ppak10/Inova/BOM/AllOtherConstructionPartsMK1_05062024.xlsx

Part Name | Part Description | Where To Buy | Notes
Balls for wobbler balancer, d. 6.35mm | Balls for wobbler balancer, d. 6.35mm | https://s.click.aliexpress.com/e/_DCx0Q8L
Gas Dumper for TopFrame, 230mm, 120N | Gas dumper for the horizontaly placed doors. | your local shop
Gas Dumper Holder | Gas dumper holder. | your local shop
Neodyme magnet 10x5mm | Magnets for wobler ballancer. | https://s.click.aliexpress.com/e/_DDN6NvZ
Spring for anti wobbler | Spring: 0,5x7x15 | https://s.click.aliexpress.com/e/_DCy5gN9
Spring for belt tensioner | Spring for belt tensioner | https://s.click.aliexpress.com/e/_DCy5gN9
Steel Hinges, 50x50mm | Hinges for the printer opening. | https://s.click.aliexpress.com/e/_DlhNYs3
L-Profile RockWool Holder | Aluminum insulation holder above the recoater, 20x40x2mm | to be manufactured | see 3D model
L-Profile Z-axes Reinforcement | Aluminum reinforcement of Z1 and Z2 axes, 30x30x4mm | to be manufactured | see 3D model
SteelMagPlate | Stell plate for the electro magnet closing. | to be manufactured | see 3D model
