ppak10/Inova/BOM/CH-PRPWSET-_-Bed-Sealing-MK1_BOM.xlsx

Part | Quantity | Notes
Bed Sealing - CornerSpringWasher | 8 | aluminum, see 3D model
Bed Sealing - Felt Sealing for Powder Bed | 2 | Nomex Felt or Ceramic Paper, see 3D model
Bed Sealing - Felt Sealing for Print Bed | 2 | Nomex Felt or Ceramic Paper, see 3D model
Bed Sealing - SideSpringWasherLong | 2 | aluminum, see 3D model
Bed Sealing - SideSpringWasherShort | 6 | aluminum, see 3D model
Bed Sealing - TopPlateSpacerLong | 2 | aluminum, see 3D model
Bed Sealing - TopPlateSpacerShort | 6 | aluminum, see 3D model
