ppak10/Inova/BOM/CH-PRPWSET-_-Chambers-for-Inova-MK1_BOM.xlsx

Part | Quantity | Notes
Chambers - BottomMovingPlate | 2 | 8mm aluminum, see 3D model
Chambers - ChamberCornerR16 | 8 | 3mm aluminum, see 3D model
Chambers - ChamberSideLong | 2 | 3mm aluminum, see 3D model
Chambers - ChamberSideShort | 6 | 3mm aluminum, see 3D model
Chambers - HeatingBlock | 8 | alu profile 1530, see 3D model
Chambers - ChamberSideConnector | 16 | 3mm aluminum, see 3D model
Chambers - PowderBedBottom | 1 | 3mm aluminum, see 3D model
Chambers - PowderBedTop | 1 | 3mm aluminum, see 3D model
Chambers - PrintBedBottom | 1 | 3mm aluminum, see 3D model
Chambers - PrintBedTop | 1 | 3mm aluminum, see 3D model
