ppak10/Inova/BOM/Fasteners_Joints_BottomFrame_MK1_05062024.xlsx

Type | Size | Length (mm) | Pcs | Joint
Socket Cap Screw | M5 | 25 | 4 | Profiles 2020 BCF/BCB + Profiles 2020 BCLR
Socket Flat Screw | M5 | 8 | 1 | Profile 20: BCC + TopChamberCover
Socket Button Screw | M5 | 10 | 5 | FrontCover + Frame
Socket Button Screw | M5 | 10 | 5 | BackCover + Frame
Socket Button Screw | M5 | 10 | 6 | RightCover + Frame
Socket Flat Screw | M5 | 12 | 2 | RightCover + Profile2020 holding Chambers
Socket Flat Screw | M5 | 12 | 2 | RightCover + Profile2020 holding LinearRails
Socket Button Screw | M5 | 10 | 6 | LeftCover + Frame
Socket Flat Screw | M5 | 12 | 2 | LeftCover + Profile2020 holding Chambers
Socket Flat Screw | M5 | 12 | 2 | LeftCover + Profile2020 holding LinearRails
Socket Flat Screw | M5 | 10 | 10 | TopFrameCover_HPL + Frame
Socket Flat Screw | M4 | 8 | 16 | TopFrameCover_HPL + TopFrameCover_ALU
Socket Flat Screw | M5 | 10 | 8 | Hinges + Frame
Socket Flat Screw | M4 | 10 | 2 | BeltTensioner_FixedReaction + RightCover
Socket Cap Screw | M4 | 16 | 2 | BeltTensioner_FixedReaction + RecoaterServiceWindowCover
Socket Cap Screw | M4 | 8 | 4 | RecoaterServiceWindowCover + BackCover
Socket Cap Screw | M4 | 8 | 1 | RecoaterServiceWindowCover+BeltTensioner_FixedReactionBrace
Socket Cap Screw | M4 | 8 | 4 | RecoaterNema17_Holder + BackCover
Socket Button Screw | M5 | 10 | 16 | insideCoverConnector + Frame
Socket Cap Screw | M4 | 8 | 8 | insideCoverConnector + InsideCovers
Socket Flat Screw | M4 | 6 | 6 | RockwoolHolders + InsideCovers
Socket Button Screw | M5 | 8 | 2 | InsideLeftWollHolder + Frame
Socket Flat Screw | M5 | 14 | 10 | TopChamberCovers + PowderMantinels + Frame
Socket Flat Screw | M5 | 12 | 3 | TopChamberCovers + Frame
Socket Cap Screw | M4 | 8 | 16 | SideCompactConnector + Left&RightCover
Socket Cap Screw | M4 | 8 | 8 | SideCompactConnector + Front&BackInsideCover
Socket Flat Screw | M4 | 10 | 6 | OverPowderBin_PrinterRails + BottomChamberCover
Socket Button Screw | M5 | 12 | 3 | OverPowderLinePlateBack + Frame
Socket Cap Screw | M4 | 18 | 8 | OverPowderLinePlateBack + OverPowderLinePlateFront
Socket Flat Screw | M4 | 10 | 2 | OverLinePlateHolder + BottomChamberCoverRight
Socket Button Screw | M4 | 10 | 4 | OverLinePlateHolder + InsideFront&BackHoldersBottom
Socket Flat Screw | M4 | 10 | 40 | OverPowderBin M4 set
Socket Flat Screw | M3 | 12 | 6 | OverPowderBin M3 set
Cylindrical Knurled Head | M5 | 10 | 1 | OverPowderBin Lock (DIN 464)
Socket Button Screw | M5 | 10 | 24 | "BottomChamberCovers" + Frame
Socket Button Screw | M4 | 8 | 30 | "CleaningCovers"+"BottomChamberCovers"
Socket Button Screw | M4 | 8 | 20 | "SSR Box": Sides + Mounts
Socket Button Screw | M5 | 16 | 4 | "SSRBoxMounts" + Frame
Socket Cap Screw | M4 | 8 | 4 | CableClipSmall + "SSRBox"
Socket Cap Screw | M4 | 8 | 4 | CableClipBig + "SSRBox"
Socket Button Screw | M5 | 8 | 4 | GasDumpers + Frame
Socket Button Screw | M5 | 10 | 8 | Z-axisReinforcements + Frame
Socket Button Screw | M5 | 8 | 28 | "Frame Blind Joint Screws"
Socket Cap Screw | M5 | 20 | 12 | "Frame Holding Z1/Z2 steppers and LinearRails"
Socket Cap Screw | M5 | 25 | 4 | "Frame Joint Holding Chambers - Bottom"
Squared Nut, Low Profile | M5 | 2.7 | 111 | "Anything" + Frame
