ppak10/Inova/BOM/Fasteners_Joints_LayerProcessor_MK1_05062024.xlsx

Type | Size | Length (mm) | Pcs | Joint
Socket Cap Screw | M3 | 18 | 1 | LeadPulley + LeadPulleyHolder (Axle)
Flat Washer | M3 | 0.5 | 2 | LeadPulley + LeadPulleyHolder (Axle)
Self Locking Nut | M3 | --- | 1 | LeadPulley + LeadPulleyHolder (Axle)
Socket Cap Screw | M5 | 30 | 2 | BeltTensionerSet: "FixedReaction Spring Guide"
Socket Cap Screw | M4 | 25 | 2 | BladeHolders + Blade
Socket Cap Screw | M3 | 10 | 8 | BladeHolders + LinearRailTrolley
Socket Cap Screw | M3 | 8 | 16 | LinearRails + Profile 2020
Profile 2020 Spring Nut | M3 | --- | 16 | LinearRails + Profile 2020
Socket Button Screw | M4 | 14 | 1 | BladeHolder + BeltLock
