ppak10/Inova/BOM/Fasteners_Joints_PowderChamber_MK1_05062024.xlsx

Type | Size | Length (mm) | Pcs | Joint
Socket Cap Screw | M3 | 8 | 8 | BedSealingSet + PrintBedBottom
Socket Flat Screw | M4 | 16 | 8 | PowderBedTop + PowderBedBottom
Socket Button Screw | M5 | 18 | 2 | PowderBedBottom + RingSpacer + MovingProfiles
Spring washer | M5 | 1.6 | 2
Socket Cap Screw | M5 | 25 | 2 | BottomMovingPlate + RingSpacer + MovingProfiles
Socket Cap Screw | M4 | 10 | 4 | RingSpacer + NutAretation
Socket Cap Screw | M4 | 12 | 3 | LeadNut + BalancerPlateBottom
Socket Cap Screw | M4 | 35 | 3 | LeadNut+BalancerPlateBottom + BottomPlate + BalancerPlateTop
M4 Nut | M4 | 3.2 | 3 | BalancerPlateBottom Aretation
Socket Cap Screw | M4 | 14 | 2 | NutHolder + BalancerPlateBottom
Socket Cap Screw | M4 | 14 | 6 | BottomMovingPlate + BottomPlateHolders
Socket Cap Screw | M3 | 12 | 8 | BottomPlateHolders + LinearRailTrolleys
Socket Button Screw | M4 | 6 | 8 | ChamberSideConnectors + ChamberSides (not frame)
Socket Cap Screw | M4 | 6 | 32 | ChamberSideConnectors + ChamberSides (not frame)
Socket Cap Screw | M4 | 5 | 24 | HeatingBlocks + ChaberSides
Socket Cap Screw | M3 | 8 | 8 | LinearRails + Profile 2020
Profile 2020 Spring Nut | M3 | --- | 8 | LinearRails + Profile 2020
Distance Washer | M5 | 0.1 | 10 | LinearRails + Profile 2020
Distance Washer | M5 | 0.2 | 10 | LinearRails + Profile 2020
Washer | 8,4x20x1,5 | 1.5 | 1 | Z-axis End-Stop
Socket Button Screw | M4 | 10 | 4 | "Chambers with Frame_Top_Xaxis"
Socket Cap Screw | M4 | 22 | 2 | "Chambers with Frame_Top_Yaxis"
Socket Cap Screw | M4 | 22 | 2 | "Chambers with Frame_Bottom"
