ppak10/Inova/BOM/Fasteners_Joints_TopFrame_MK1_05062024.xlsx

Type | Size | Length (mm) | Pcs | Joint
Socket Flat Screw | M5 | 10 | 10 | TopTopCover + Frame
Socket Button Screw | M5 | 10 | 6 | RightCover + Frame
Socket Button Screw | M5 | 10 | 6 | LeftCover + Frame
Socket Button Screw | M5 | 10 | 7 | FrontCover + Frame
Socket Button Screw | M5 | 10 | 8 | BackCover + Frame
Socket Flat Screw | M5 | 10 | 10 | TopBottomCover_HPL + Frame
Socket Button Screw | M5 | 12 | 3 | RightInsideCover + Frame
Socket Button Screw | M5 | 12 | 3 | LeftInsideCover + Frame
Socket Button Screw | M5 | 12 | 3 | FrontInsideCover + Frame
Socket Button Screw | M5 | 12 | 3 | BackInsideCover + Frame
Socket Flat Screw | M4 | 8 | 16 | TopBottomCover_HPL + TopBottomCover_ALU
Socket Button Screw | M5 | 12 | 8 | TopCenterCover + Frame
Socket Flat Screw | M5 | 12 | 4 | Left&RightCovers + InsideProfiles (holding electronics)
Socket Flat Screw | M5 | 10 | 8 | ElectronicPlate + InsideProfiles (holding electronics)
Socket Cap Screw | M4 | 8 | 8 | WindowsHolder + TopCenterCover
Socket Flat Screw | M5 | 10 | 8 | Hinges + Frame
Socket Button Screw | M5 | 8 | 4 | GasDumpers + Frame
Socket Cap Screw | M4 | 8 | 12 | Halogen Heaters: HalogenHeaterHolder + TopBottomCover_Alu
Socket Cap Screw | M4 | 6 | 32 | Halogen Heaters: HalogenHeaterHolder + Shields
Socket Cap Screw | M4 | 10 | 8 | Halogen Heaters: HalogenTubes position set screws
Socket Button Screw | M5 | 10 | 4 | "Frame Blind Joint Screws: Inside Frame"
Squared Nut, Low Profile | M5 | 2.7 | 79 | "Anything" + Frame
