ppak10/Inova/BOM/Fasteners_MK1_05062024.xlsx

Part | Quantity | Where to buy | Notes
Cylindrical Knurled Head M5x10 | 1 | your local shop
Distance Washer M5x0,1 | 20 | your local shop
Distance Washer M5x0,2 | 20 | your local shop
Nut M4x3,2 | 6 | your local shop
Square Low Profile Nut M5x2,7 | 200 | your local shop
Profile 2020 Spring Nut M3 | 32 | your local shop
PTFE Washer 4x10x1 | 50 + some spare | https://www.aliexpress.com/store/3209034 | Ask for custom dimensions
PTFE Washer 5x10x1 | 16 + some spare | https://www.aliexpress.com/store/3209034 | Ask for custom dimensions
PTFE Washer 5x18x3 | 77 + some spare | https://www.aliexpress.com/store/3209034 | Ask for custom dimensions
Self Locking Nut | 1 | your local shop
Socket Button Screw M3x16 | 4 | your local shop
Socket Button Screw M3x6 | 10 | your local shop
Socket Button Screw M4x10 | 12 | your local shop
Socket Button Screw M4x14 | 4 | your local shop
Socket Button Screw M4x18 | 2 | your local shop
Socket Button Screw M4x6 | 16 | your local shop
Socket Button Screw M4x8 | 50 | your local shop
Socket Button Screw M5x10 | 125 | your local shop
Socket Button Screw M5x12 | 25 | your local shop
Socket Button Screw M5x16 | 4 | your local shop
Socket Button Screw M5x18 | 4 | your local shop
Socket Button Screw M5x8 | 38 | your local shop
Socket Cap Screw M2x4 | 4 | your local shop
Socket Cap Screw M3x10 | 21 | your local shop
Socket Cap Screw M3x12 | 16 | your local shop
Socket Cap Screw M3x18 | 5 | your local shop
Socket Cap Screw M3x25 | 4 | your local shop
Socket Cap Screw M3x8 | 79 | your local shop
Socket Cap Screw M4x10 | 16 | your local shop
Socket Cap Screw M4x12 | 9 | your local shop
Socket Cap Screw M4x14 | 16 | your local shop
Socket Cap Screw M4x16 | 2 | your local shop
Socket Cap Screw M4x18 | 11 | your local shop
Socket Cap Screw M4x22 | 8 | your local shop
Socket Cap Screw M4x25 | 2 | your local shop
Socket Cap Screw M4x35 | 6 | your local shop
Socket Cap Screw M4x5 | 48 | your local shop
Socket Cap Screw M4x6 | 96 | your local shop
Socket Cap Screw M4x8 | 125 | your local shop
Socket Cap Screw M5x20 | 12 | your local shop
Socket Cap Screw M5x25 | 12 | your local shop
Socket Cap Screw M5x30 | 2 | your local shop
Socket Flat Screw M3x12 | 6 | your local shop
Socket Flat Screw M3x8 | 12 | your local shop
Socket Flat Screw M4x10 | 50 | your local shop
Socket Flat Screw M4x16 | 16 | your local shop
Socket Flat Screw M4x6 | 6 | your local shop
Socket Flat Screw M4x8 | 44 | your local shop
Socket Flat Screw M5x10 | 54 | your local shop
Socket Flat Screw M5x12 | 15 | your local shop
Socket Flat Screw M5x14 | 10 | your local shop
Socket Flat Screw M5x8 | 1 | your local shop
Spring washer M5x1,6 | 4 | your local shop
Washer 8,4x20x1,5 | 2 | your local shop
Washer M3x0,5 | 2 | your local shop
