ppak10/Inova/BOM/Heating_MK1_05062024.xlsx

Part | Description | Quantity | Where to buy | Notes
Ceramic Socket r7s | Ceramic socket r7s for halogen heaters. | 8 | https://s.click.aliexpress.com/e/_DCzVFIX | Type: any, you need just a ceramic part
Halogen Heater 185mm 110V or 230V | Halogen Tube 200W, 185mm, R7s socket, half-shielded | 2 + 2 spare | https://s.click.aliexpress.com/e/_DDVj12b | Ask for customization
Halogen Heater 220mm 110V or 230V | Halogen Tube 200W, 220mm, R7s socket, half-shielded | 2 + 2 spare | https://s.click.aliexpress.com/e/_DDVj12b | Ask for customization
Heating Cartridges 110V or 230V | d6x140mm, M10 thread, 110/230V, 200W, 2m cable | 8 | https://s.click.aliexpress.com/e/_Dnl1lfz | Ask for customization - see 3D model
Heating Pad - Powder Bed 110V or 230V | 120x165mm Flexible Silicone Heating Bed 230V/110V, 200W | 1 | https://s.click.aliexpress.com/e/_DB4F0r1 | Ask for customization - see 3D model
Heating Pad - Print Bed 110V or 230V | 120x120mm Flexible Silicone Heating Bed 230V/110V, 200W | 1 | https://s.click.aliexpress.com/e/_DB4F0r1 | Ask for customization - see 3D model
Thermistor NTC3950 | Type NTC 3950 100k, M3 thread, 2m cable | 8 + 2 spare | https://s.click.aliexpress.com/e/_DkgYC1N | Ask for customization - 2m cable
