ppak10/Inova/BOM/HHEAD-ShieldSet-_-Halogen-Head_-Shield-Set_BOM.xlsx

Part | Quantity | Notes
Halogen Head: HeaterHolder1 | 2 | see 3D model
Halogen Head: HeaterHolder2 | 2 | see 3D model
Halogen Head: Shield185In | 2 | see 3D model
Halogen Head: Shield185Out | 2 | see 3D model
Halogen Head: Shield220In | 2 | see 3D model
Halogen Head: Shield220Out | 2 | see 3D model
