ppak10/Inova/BOM/LinearTechnics_MK1_05062024.xlsx

Part | Description | Quantity | Where to buy | Notes
Axial Bearings: 8x16x5 | Used in the Z1, Z2 NEMA17 holders. | 4 | https://s.click.aliexpress.com/e/_De1IwAr | Type: F8-16M 8 x 16 x 5mm
Ball Screw 1204 + Nut | Set for print & powder bed. | 2 | https://s.click.aliexpress.com/e/_DeIB02R | Ask for customization - see 3D model
GT2 Belt - Heat Resistant up to 135C | Used for recoater. Length: 1,25m | 1 | https://s.click.aliexpress.com/e/_DFZJ5G7 | Type:2M
GT2 Pulley - 20Z | Recoater stepper pulley - 20T. | 1 | https://s.click.aliexpress.com/e/_DDqpjtD | Type: Bore 3mm With Teeth
GT2 Tension Pulley 20T | Belt tensioning pulley - 20T. | 1 | https://s.click.aliexpress.com/e/_DDqpjtD | Type: Bore 3mm With Teeth
Hard Coupling 5/8 (For Stepper and Ball Screw) | Hard coupling for Z1 and Z1 steppers. Size: 20/25, 5/8mm | 2 | https://s.click.aliexpress.com/e/_DlnVikr | Type: 5x8
Lock Collar T8 | Stop for the Z1 and Z2 home positions. | 2 | https://vi.aliexpress.com/item/1005005321139532.html
MGN12H Linear rail & trolley set: 300mm | Used for print bed & powder bed Z-moves. | 4 | https://s.click.aliexpress.com/e/_Dnc20mn | Type: 300mm, MGN12H
MGN12H Linear rail & trolley set: 550mm | Used for the recoater moves. | 2 | https://s.click.aliexpress.com/e/_Dnc20mn | Type: 550mm, MGM12H
