ppak10/Inova/BOM/Electronics_MK1_05062024.xlsx

Part | Description | Quantity | Where to buy | Notes
10 pin Ribbon Cable, 60cm | BTT Board - GATE1 connestion. EXT connectors. | 2 | https://s.click.aliexpress.com/e/_DBJhg1t
40 pin Cable, 30cm | Raspberry Pi 5 - GATE1 connection. 40-pin header. | 1 | https://s.click.aliexpress.com/e/_DFkQEoB
Arduino Nano v3 | Arduino Nano v3 with pin header. | 1 | https://vi.aliexpress.com/item/1005001447227362.html
BTT SKR V1.4 Turbo 32-Bit + 3xTMC2209 | Big Tree Tech control board: SKR 1.4 Turbo + 3xTMC2209 | 1 | https://s.click.aliexpress.com/e/_DCPX7z5
Buck Convertor DC12V -> DC5V | PSU for Raspberry Pi. | 1 | https://s.click.aliexpress.com/e/_DdI4QqR
Cable Set for MK1 | Complete cabling for Inova MK1. | 1 | your local shop | To be manufactured by you.
Cable Splitter, 5pin | Cable splitter - 5pin | 1 | https://s.click.aliexpress.com/e/_DdmIh07 | Type: 5P
Cable Splitter, 8pin | Calble splitter - 8pin | 6 | https://s.click.aliexpress.com/e/_DdmIh07 | Type: 8P
Cable Splitter Holder | Cable Splitter Holder | 7 | https://s.click.aliexpress.com/e/_DdmIh07 | Type: DF-21
ElectroMagnet P30/25 | Safety closure of the printer. | 1 | https://s.click.aliexpress.com/e/_DDrr8pD | Type: P30H25mm 15KG
Ethernect CAT5 Cable 1,5m | Extension of the ethernet from RPi to the printer socket. | 1 | https://s.click.aliexpress.com/e/_DDT7jtl
Fan 120mm, Arctic P12 | Electronics cooling fans. | 4 | https://s.click.aliexpress.com/e/_DljPHpH
Fan 80mm, Arctic P8 | Raspberry Pi 5 Extra Fan. | 1 | https://s.click.aliexpress.com/e/_DmlbVyF
Fan Hub 5 Fans, 40cm | Electronics fans poweline. | 1 | https://s.click.aliexpress.com/e/_DEdEvDl
HDMI Adapter 180° for HDMI Display | 180° adapter for the touch screen connection. | 1 | https://s.click.aliexpress.com/e/_DeGB45p | Type: Option1 Standard
HDMI Display 1024x600, touchscreen, 7 inch, IPS | Printer's UI. | 1 | https://s.click.aliexpress.com/e/_Dke0CxH | Type: Option 2 IPS
HDMI Extension Cable 3m | Raspberry Pi 5 - TouchScreen connection. | 1 | https://s.click.aliexpress.com/e/_DBixH4F
Key Switch On-Off | Safety key-switch for the laser. | 1 | https://s.click.aliexpress.com/e/_DEv2V5H
Main Power Cable 110V/230V | Main power supply cable - IEC C13 | 1 | https://www.aliexpress.com/item/1005003992286721.html | choose appropriate socket type
Mean Well: PSU 12V/350W | Main PSU for 12V, 350W. | 1 | https://s.click.aliexpress.com/e/_DdSe6PV
Micro Switch ZIPPY VM-05S-00D0-Z | Safety switches for laser. | 3 | https://s.click.aliexpress.com/e/_DCWCfUF
NEMA17 Extension Cable | Extension cables for the Z1 and Z2 steppers, 4 pins. | 2 | your local store
Power Socket ICE C14, back light, fuse, 230V | Backlighted power switch/C14 socket with fuse - 110/230V | 1 | https://s.click.aliexpress.com/e/_DeLZ0Bd | Type: AC-01B-1
Raspberry Pi 5, 4GB RAM | Raspberry Pi 5, 4GB RAM. | 1 | https://s.click.aliexpress.com/e/_DkURsRH | 4GB RAM is minimum
Ribbon Flex CSI Cable 15 Pin, 50cm, for RPi Camera | Video camera - Raspberry Pi 5 Connection. | 1 | https://s.click.aliexpress.com/e/_Dli5LEf | Type: Cable-500mm
RJ 45 Socket | RJ45 panel socket. | 1 | https://s.click.aliexpress.com/e/_Dl8Msg7
RPi CPU Heatsink Radiator | Passive Raspberry Pi heatsing radiator: 25x25x10mm | 1 | https://s.click.aliexpress.com/e/_Dd1LD5v
RTC Battery Case for RPi | RTC Battery Case for RPi | 1 | https://s.click.aliexpress.com/e/_DdzHK1N
SLS4All GATE1 Control Board | Galvo and temperature conrol board. | 1 | https://sls4all.com/store
SLS4All ZERO1 Detector | Zero-cross detection board for halogen regulation. | 1 | https://sls4all.com/store
Soft Swicht, backlighted | Front backlit switch of the printer: 110-220V, momentary | 1 | https://s.click.aliexpress.com/e/_Dk6E8sx | Type: 110-220V, momentary
SSR GEYA GSR2-10DA: Random | Solid state relay for halogen heating - 1 channel, max. 480VAC/10A, random | 4 | https://s.click.aliexpress.com/e/_DDTgknD | Type: GSR1-1-10DA, customized: type Random
SSR GEYA GSR2-10DA: Zero Cross | Solid state relay for heat cartridges and printer power - 1 channel, max. 480VAC/10A, zero-cross | 11 | https://s.click.aliexpress.com/e/_DDTgknD | Type: GSR1-1-10DA
Stepper motors NEMA 17 17HS19-2004S1 0,59Nm | NEMA17 steppers for Z1, Z2 and R axes. | 3 | https://s.click.aliexpress.com/e/_Dk5Clej
ThermoCam Waveshare MLX90640 | Thermal imagng camera for halogen heating regulation. 32x24px | 1 | https://s.click.aliexpress.com/e/_DlmKoCF
USB 2.0 Extension Cable, 3m | USB extension cable for external USB devices. | 1 | https://s.click.aliexpress.com/e/_DCZiFfN
USB-C 5V Power Cable | Power cable for Raspberry Pi. | 1 | https://s.click.aliexpress.com/e/_DEzD047 | Type: Type-c male 2pin
USB Cable: 90° USB 2.0 -> microUSB, Vention 3m | Touch screen data and power supply. | 1 | https://s.click.aliexpress.com/e/_DenExPN | Type: Left, 3m
VideoCam 5MP for RPi | Video camera for Raspberry Pi, 130 degree view. | 1 | https://s.click.aliexpress.com/e/_DedgDoJ | Type: Option 7
