ppak10/Inova/BOM/Fasteners_Joints_HoldersOpticsElectronics_MK1_05062024.xlsx

Type | Size | Length (mm) | Pcs | Joint
Socket Cap Screw | M3 | 8 | 4 | RecoaterNema17_Holder + RecoaterNema17
Socket Button Screw | M5 | 10 | 8 | Nema17ZAxisHolders + Frame
Socket Button Screw | M3 | 16 | 4 | Nema17ZAxisHolders + Nema17
Socket Button Screw | M4 | 14 | 6 | Nema17ZAxisHolder + Nema17HolderLid
Socket Cap Screw | M4 | 8 | 30 | SSRs + BackCover
Socket Cap Screw | M4 | 8 | 4 | MainPSUHolder + BackCover
Socket Flat Screw | M4 | 8 | 4 | PSU(DC12V350W) + MainPSUHolder
Socket Cap Screw | M4 | 8 | 4 | LaserModuleHolder + ElectronicPlate
Socket Flat Screw | M3 | 8 | 4 | LaserModule + LaserModuleHolder
Socket Cap Screw | M4 | 8 | 4 | GalvoPSUHolder + ElectronicPlate
Socket Flat Screw | M3 | 8 | 4 | GalvoPSU + GalvoPSUHolder
Socket Cap Screw | M4 | 18 | 3 | GalvoHolder + ElectronicPlate
Socket Button Screw | M4 | 18 | 2 | Galvo SC/DT/40 + Galvo Holder
Socket Cap Screw | M3 | 8 | 4 | FrontGalvoLid + GalvoHolder
Socket Cap Screw | M3 | 8 | 4 | TopGalvoLid + GalvoHolder
Socket Cap Screw | M4 | 8 | 4 | GalvoDriverCooler + ElectronicPlate
Socket Cap Screw | M4 | 12 | 2 | GalvoDriver + GalvoDriverCooler + ElectronicPlace
Socket Cap Screw | M3 | 8 | 7 | WagoHolders + ElectronicPlate
Socket Cap Screw | M4 | 8 | 4 | DisplayHolder Left&Right Side + "BottomFrame"
Socket Button Screw | M3 | 6 | 4 | TopDisplayCover + Left&RightSideHolder
Socket Button Screw | M3 | 6 | 4 | TopDisplayCover + Display
Socket Cap Screw | M3 | 10 | 4 | BTB + ElectronicPlate
Socket Cap Screw | M3 | 25 | 4 | RockPi + ElectronicPlate
Socket Cap Screw | M3 | 8 | 2 | SocketRJ45 + "SSRBox"
Socket Flat Screw | M3 | 8 | 2 | MainPowerCombo + "SSRBox"
Socket Cap Screw | M4 | 8 | 4 | RockPiFanHolder + RockPiFan80mm
Socket Flat Screw | M4 | 8 | 4 | RockPiFanHolder + TopTopCover
Socket Cap Screw | M3 | 10 | 4 | BuckConvertor + ElectronicPlate
Socket Cap Screw | M3 | 10 | 5 | GATE1 Board + ElectronicPlate
Socket Button Screw | M5 | 10 | 16 | FanCover120 + Fan120mm + TopTopCover
Socket Cap Screw | M3 | 8 | 4 | BeamCoverLeft + Lensholder
Socket Cap Screw | M3 | 8 | 2 | BeamCoverLeft + ElectronicPlate
Socket Cap Screw | M3 | 8 | 2 | LensHolder + ElectronicPlate
Socket Cap Screw | M4 | 8 | 2 | VideoCameraHolder + ElectronicPlate
Socket Cap Screw | M2 | 4 | 2 | VideoCamera + VideoCameraHolder
Socket Cap Screw | M2 | 4 | 2 | ThermoCamera + ThermoCameraHolder
Socket Cap Screw | M4 | 12 | 1 | ElectroMagnet3025 + ElMagnetHolder
Socket Button Screw | M3 | 6 | 2 | CameraLaserFilter + VideoCameraHolder
Socket Button Screw | M5 | 16 | 2 | ElMagnetHolder + Frame
Socket Flat Screw | M4 | 8 | 4 | SteelMagPlate + TopFrameCover
Socket Flat Screw | M3 | 8 | 2 | SafetySwitchHolderTop + TopBottomCover_HPL
Socket Cap Screw | M3 | 18 | 1 | SafetySwitchTop + SafetySwitchHolderTop
Socket Cap Screw | M3 | 8 | 2 | SafetySwitchHolderBottom + BottomChamberCoverRight
Socket Cap Screw | M3 | 18 | 1 | SafetySwitchBottom + SafetySwitchHolderBottom
Socket Cap Screw | M3 | 18 | 2 | GalvoWindoSafetySwitch + GalvoHolder
Squared Nut, Low Profile | M5 | 2.7 | 10 | "Anything" + Frame
