ppak10/Inova/BOM/Optics_MK1_05062024.xlsx

Part | Description | Quantity | Where to buy | Notes
Galvo Scanner DT40 40kpps | Galvo scanner Dragon Tiger DT40, 40kpps | 1 | https://vi.aliexpress.com/item/10000209859252.html | Type: LH-DT40K, No Dis and Ilda
Laser Glass Window - Big | ArtGalss AR 70, WaterWhite - main laser window, 68x86mm, th. 2mm | 1 + 1 spare | your local shop
Laser Glass Window - Small | ArtGalss AR 70, WaterWhite - galvo proctive window, 47x31mm, th. 2mm | 1 + 1 spare | your local shop
Laser Module 10W | LaserTree laser module incl. driver, 80W/10W, fix focus 450nm 2x 5W, LD+FAC+C technology | 1 | https://s.click.aliexpress.com/e/_DlRWMYx | Type: LT-80W-AA-PRO, 12V
Plano-convex Lens F65mm D42mm | Laser beam focusing lens. | 1 | https://vi.aliexpress.com/item/1005003451917165.html | Type: D42 F65 C8.2 E2.4
ZnSe Window D15x1mm | Thermal camera protective ZnSe window. | 1 | https://s.click.aliexpress.com/e/_DE1rYbz | Type: Type5, custom coating for 2-14 μm
