ppak10/Inova/BOM/ALUB-FRAME-SET-_-ALU-Sheet_-Bottom-Frame-Set_BOM.xlsx

Part | Quantity | Notes
ALU Sheet: InsideCoverBack | 1 | see 3D model
ALU Sheet: InsideCoverFront | 1 | see 3D model
ALU Sheet: InsideCoverLeft | 1 | see 3D model
ALU Sheet: InsideCoverRight | 1 | see 3D model
ALU Sheet: InsideFront&BackHolderBottom | 2 | see 3D model
ALU Sheet: InsideLeftWoolHolder | 1 | see 3D model
ALU Sheet: OverPowderLinePlateBack | 1 | see 3D model
ALU Sheet: OverPowderLinePlateFront | 1 | see 3D model
ALU Sheet: PowderMantinelBack | 1 | see 3D model
ALU Sheet: PowderMantinelFront | 1 | see 3D model
ALU Sheet: TopChamberCover | 1 | see 3D model
ALU Sheet: TopFrameCover | 1 | see 3D model
