ppak10/Inova/BOM/ALUT-FRAME-SET-_-ALU-Sheets_-Top-Frame-Set_BOM.xlsx

Part | Quantity | Notes
ALU Sheet: BottomCover | 1 | see 3D model
ALU Sheet: Front&BackInsideCover | 2 | see 3D model
ALU Sheet: LeftInsideCover | 1 | see 3D model
ALU Sheet: RightInsideCover | 1 | see 3D model
ALU Sheet: TopCenterCover | 1 | see 3D model
