ppak10/Inova/BOM/HPLB-FRAME-SET-_-HPL-Sheets_-Bottom-Frame-Set_BOM.xlsx

Part | Quantity | Notes
HPL Sheet: BackCover | 1 | see 3D model
HPL Sheet: BalancerPlateBottom | 1 | see 3D model
HPL Sheet: BalancerPlateTop | 1 | see 3D model
HPL Sheet: BinBackSide | 1 | see 3D model
HPL Sheet: BinBottom | 1 | see 3D model
HPL Sheet: BinFrontSide | 1 | see 3D model
HPL Sheet: BinIntakeExtension | 1 | see 3D model
HPL Sheet: BinLidRail | 1 | see 3D model
HPL Sheet: BinSideLeft | 1 | see 3D model
HPL Sheet: BinSideRight | 1 | see 3D model
HPL Sheet: BinTop | 1 | see 3D model
HPL Sheet: BottomChamberCoverCenter | 1 | see 3D model
HPL Sheet: BottomChamberCoverLeft | 1 | see 3D model
HPL Sheet: BottomChamberCoverRight | 1 | see 3D model
HPL Sheet: ElectricBoxCover | 1 | see 3D model
HPL Sheet: ElectricBoxSideL | 1 | see 3D model
HPL Sheet: ElectricBoxSideR | 1 | see 3D model
HPL Sheet: FrontCover | 1 | see 3D model
HPL Sheet: InsideConnector | 12 | see 3D model
HPL Sheet: LeftCover | 1 | see 3D model
HPL Sheet: RecoaterNema17Holder | 1 | see 3D model
HPL Sheet: RecoaterProfileWasherLeft | 2 | see 3D model
HPL Sheet: RecoaterProfileWasherRight | 2 | see 3D model
HPL Sheet: RecoaterServiceWindowCover | 1 | see 3D model
HPL Sheet: RightCover | 1 | see 3D model
HPL Sheet: RingSpacer | 2 | see 3D model
HPL Sheet: TopFrameCover | 1 | see 3D model
HPL Sheet: TopFrameCoverConnector | 4 | see 3D model
HPL Sheet: CleaningCoverCenter | 1 | see 3D model
HPL Sheet: CleaningCoverPRFB | 2 | see 3D model
HPL Sheet: CleaningCoverPRR | 1 | see 3D model
HPL Sheet: CleaningCoverPWFB | 2 | see 3D model
HPL Sheet: CleaningCoverPWL | 1 | see 3D model
