ppak10/Inova/BOM/HPLT-FRAME-SET-_-HPL-Sheets_-Top-Frame-Set_BOM.xlsx

Part | Quantity | Notes
HPL Sheet: BottomFrameCoverConnector | 4 | see 3D model
HPL Sheet: ElectronicPlate | 1 | see 3D model
HPL Sheet: TopBackCover | 1 | see 3D model
HPL Sheet: TopBottomCover | 1 | see 3D model
HPL Sheet: TopFrontCover | 1 | see 3D model
HPL Sheet: TopLeftCover | 1 | see 3D model
HPL Sheet: TopRightCover | 1 | see 3D model
HPL Sheet: TopTopCover | 1 | see 3D model
HPL Sheet: WindowsHolder | 1 | see 3D model
