ppak10/Inova/BOM/INSULB-SET-_-Insulation-Set-Bottom_BOM.xlsx

Part | Quantity | Notes
Insulation: BtFront&BackRockWool_Top | 2 | see 3D model
Insulation: BtFrontRockWool_Bt | 2 | see 3D model
Insulation: BtLeft&RightRockWool_Bt | 2 | see 3D model
Insulation: BtLeft&RightRockWool_Top | 2 | see 3D model
Insulation: CeramicPaper_Back | 1 | see 3D model
Insulation: CeramicPaper_Front | 1 | see 3D model
