ppak10/Inova/BOM/INSULT-SET-_-Insulation-Set-Top_BOM.xlsx

Part | Quantity | Notes
Insulation: ThCamPaperInsulation | 1 | see 3D model
Insulation: TopRockWoolLeft | 1 | see 3D model
Insulation: TopRockWoolRight | 1 | see 3D model
