ppak10/Inova/BOM/PROF2020-BOTTOM-SET-_-Profiles-2020-Bottom-Frame-Set_BOM.xlsx

Part | Quantity | Notes
MovingProfile | 4 | see 3D model
Profile 20x20: B1FB | 2 | see 3D model
Profile 20x20: B1LR | 2 | see 3D model
Profile 20x20: B2LR | 2 | see 3D model
Profile 20x20: B3B | 1 | see 3D model
Profile 20x20: B3F | 1 | see 3D model
Profile 20x20: B3ILR | 2 | see 3D model
Profile 20x20: B3LR | 2 | see 3D model
Profile 20x20: B4FB | 2 | see 3D model
Profile 20x20: B4IFB | 2 | see 3D model
Profile 20x20: B4LR | 2 | see 3D model
Profile 20x20: BCB | 1 | see 3D model
Profile 20x20: BCC | 1 | see 3D model
Profile 20x20: BCF | 1 | see 3D model
Profile 20x20: BCLR | 2 | see 3D model
Profile 20x20: BCRFB | 4 | see 3D model
Profile 20x20: BRB | 1 | see 3D model
Profile 20x20: BRF | 1 | see 3D model
Profile R20x20: FLBR | 2 | see 3D model
Profile R20x20: FRBL | 2 | see 3D model
