ppak10/Inova/3D_Printed_Tools/CakeRemovalTool/CRT_Left.stl

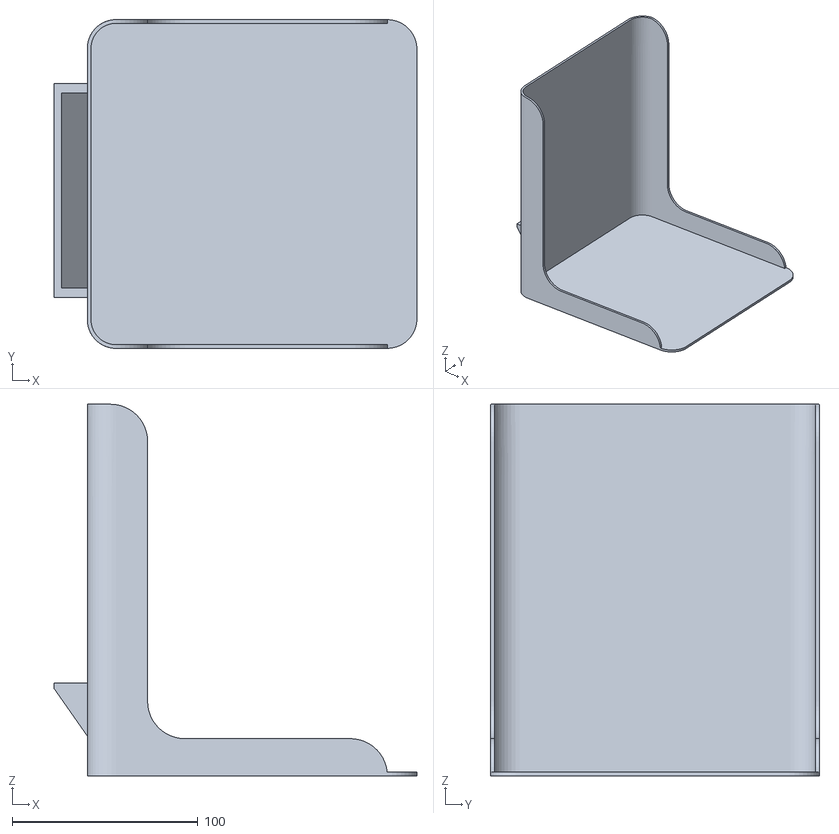
[picture p1: CAD file, 2025-12-07]
3D_Printed_Tools/CakeRemovalTool/CRT_Left.stl
195.4 x 177.0 x 200.0
