ppak10/Inova/3D_Printed_Tools/GA Calibration Tool/GA CalibrationTool.stl

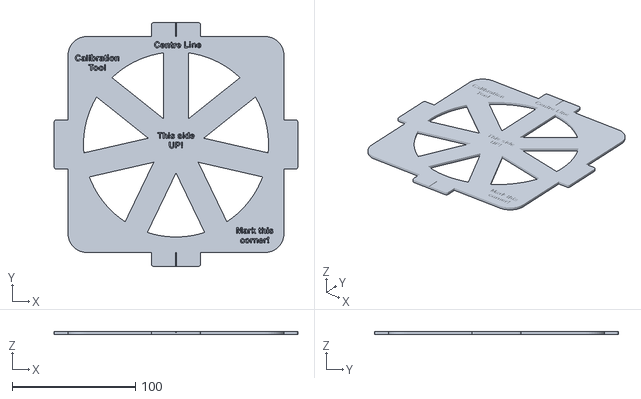
[picture p2: CAD file, 2025-12-07]
3D_Printed_Tools/GA Calibration Tool/GA CalibrationTool.stl
197.8 x 197.8 x 2.50
