ppak10/Inova/3D_Printed_Tools/PowderCompactionTool/PowderCompactionTool.stl

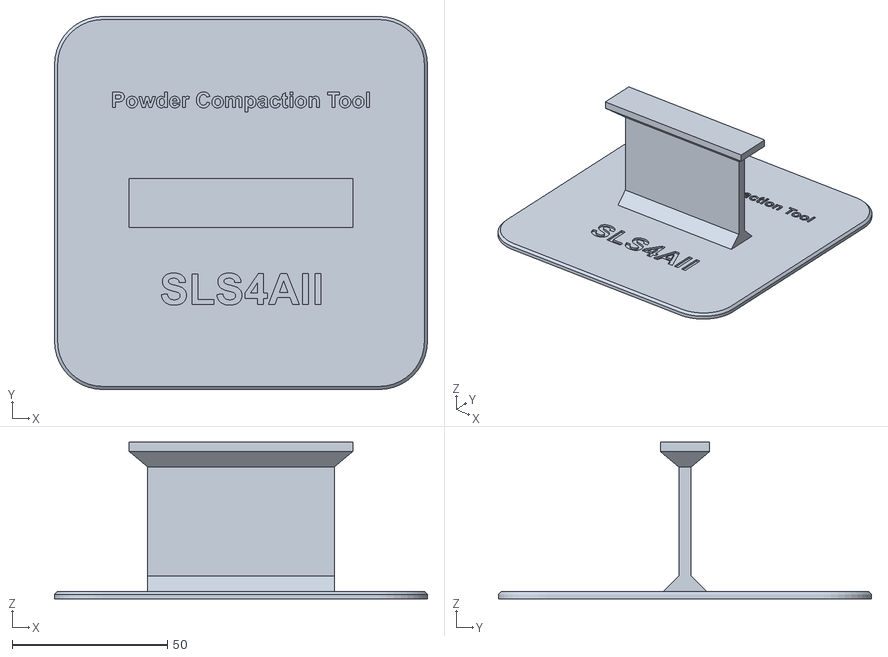
[picture p3: CAD file, 2025-12-07]
3D_Printed_Tools/PowderCompactionTool/PowderCompactionTool.stl
120.0 x 120.0 x 50.4
