ppak10/Inova/3D_PrintedParts_v1_00_1829_07062024/BeltTensionerSet/FixedReaction.stl

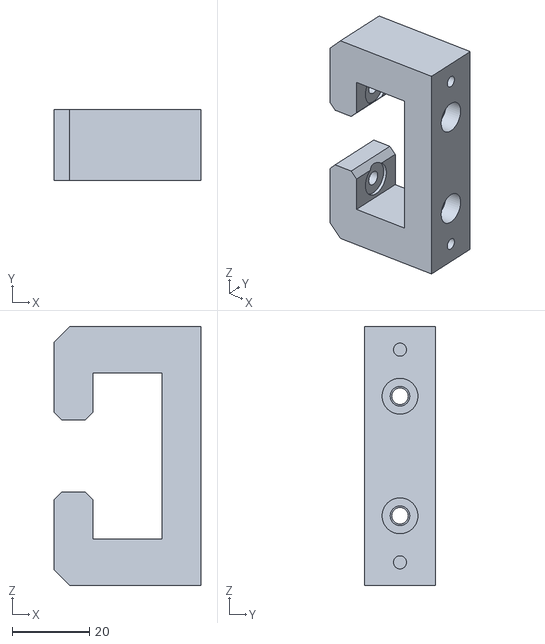
[picture p4: CAD file, 2024-09-02]
3D_PrintedParts_v1_00_1829_07062024/BeltTensionerSet/FixedReaction.stl
38.0 x 18.5 x 67.1
