ppak10/Inova/3D_PrintedParts_v1_00_1829_07062024/BladeHolderSet/BladeHolderFront.stl

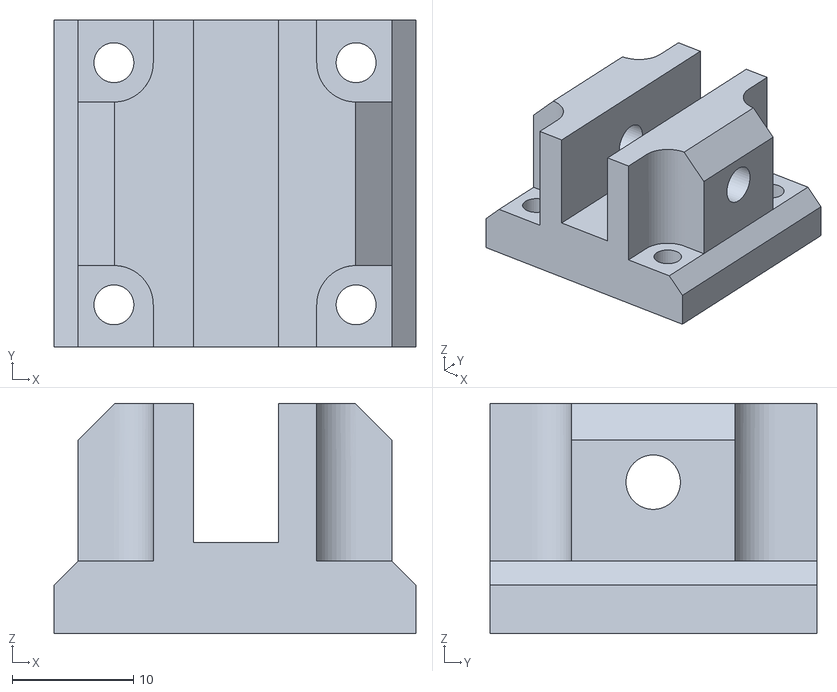
[picture p5: CAD file, 2024-09-02]
3D_PrintedParts_v1_00_1829_07062024/BladeHolderSet/BladeHolderFront.stl
29.9 x 27.0 x 19.0
