ppak10/Inova/3D_PrintedParts_v1_00_1829_07062024/BottomPlateHolders/BottomPlateHolder.stl

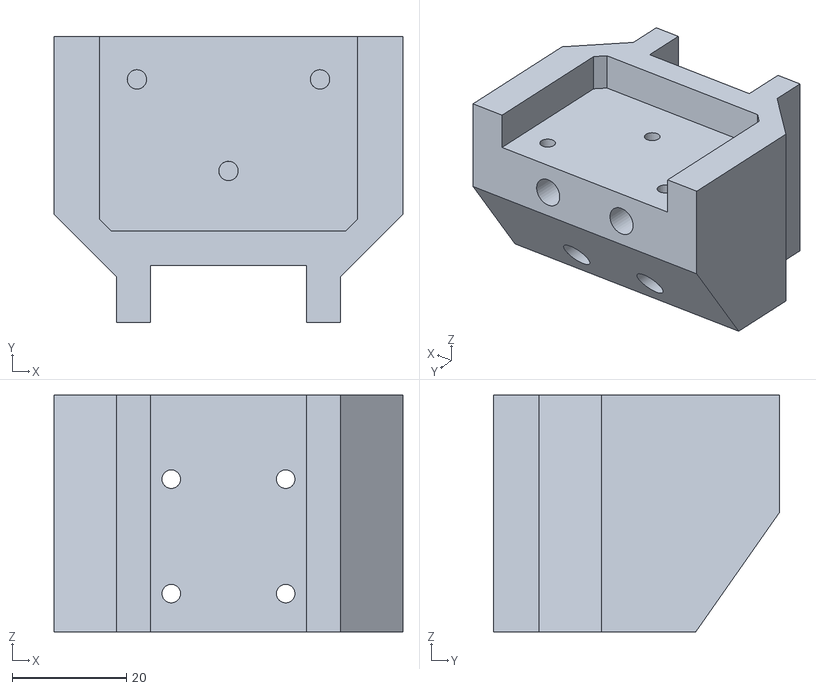
[picture p6: CAD file, 2024-09-02]
3D_PrintedParts_v1_00_1829_07062024/BottomPlateHolders/BottomPlateHolder.stl
61.0 x 50.0 x 41.4
