ppak10/Inova/3D_PrintedParts_v1_00_1829_07062024/CableClips/CableClipSmall.stl

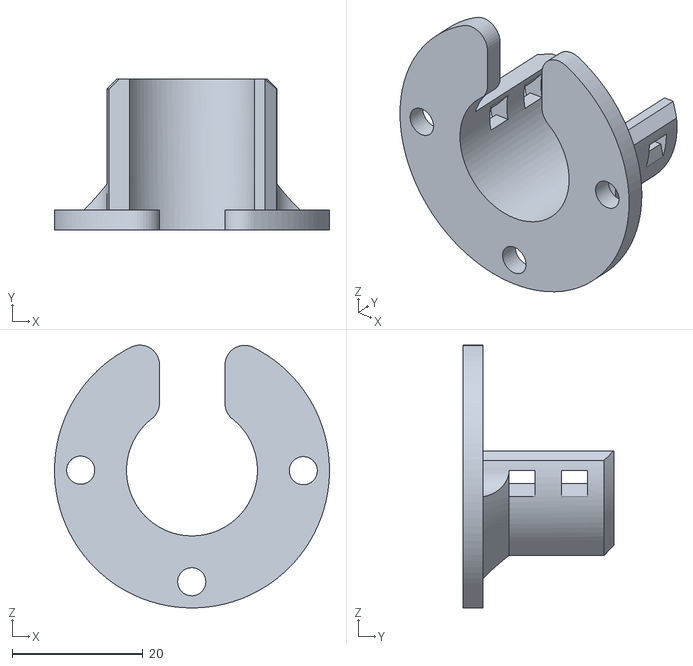
[picture p7: CAD file, 2024-09-02]
3D_PrintedParts_v1_00_1829_07062024/CableClips/CableClipSmall.stl
42.0 x 23.0 x 40.1
