ppak10/Inova/3D_PrintedParts_v1_00_1829_07062024/DisplaySet/RightSideHolder.stl

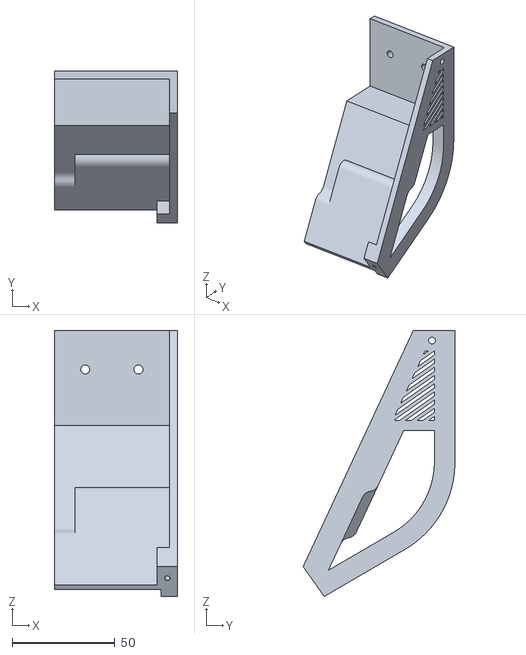
[picture p8: CAD file, 2024-09-02]
3D_PrintedParts_v1_00_1829_07062024/DisplaySet/RightSideHolder.stl
60.0 x 74.1 x 129.6
