ppak10/Inova/3D_PrintedParts_v1_00_1829_07062024/ElectroMagnetHolder/ElMagnetHolder.stl

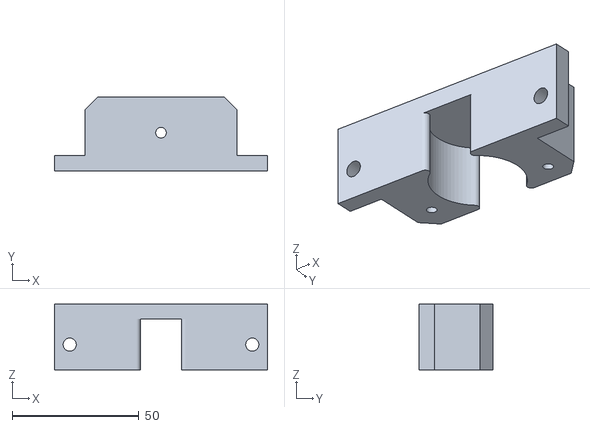
[picture p10: CAD file, 2024-09-02]
3D_PrintedParts_v1_00_1829_07062024/ElectroMagnetHolder/ElMagnetHolder.stl
84.0 x 29.0 x 26.0
