ppak10/Inova/3D_PrintedParts_v1_00_1829_07062024/ElectronicsDistanceSpacers/ElectronicSpacer_20mm.stl

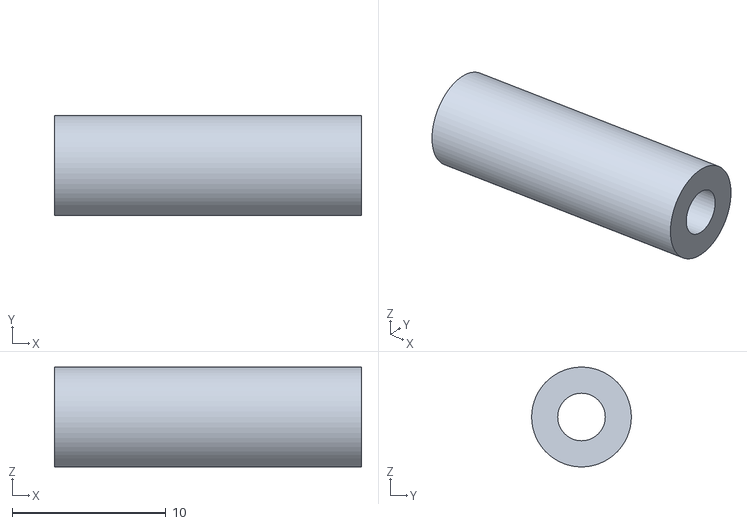
[picture p11: CAD file, 2024-09-02]
3D_PrintedParts_v1_00_1829_07062024/ElectronicsDistanceSpacers/ElectronicSpacer_20mm.stl
20.0 x 6.50 x 6.49
