ppak10/Inova/3D_PrintedParts_v1_00_1829_07062024/FanCovers120/FanCover120.stl

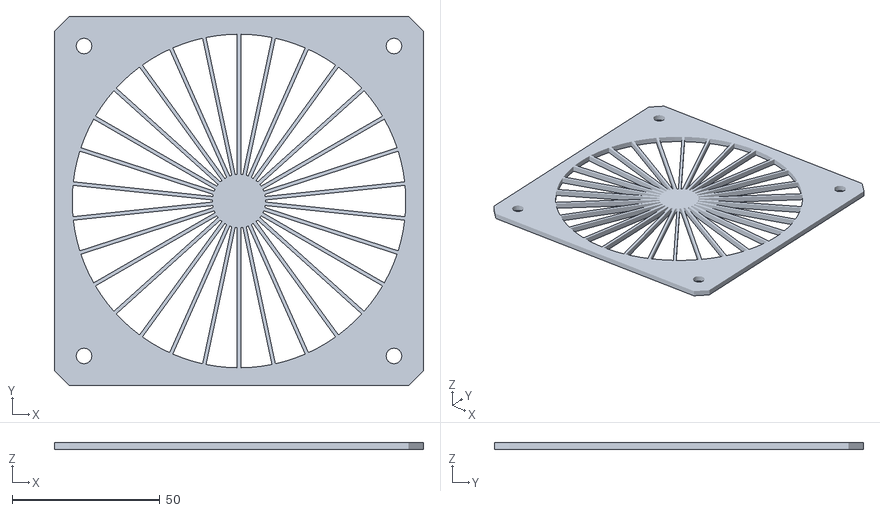
[picture p12: CAD file, 2024-09-02]
3D_PrintedParts_v1_00_1829_07062024/FanCovers120/FanCover120.stl
125.0 x 125.0 x 2.50
