ppak10/Inova/3D_PrintedParts_v1_00_1829_07062024/LensHolder_D42F65/BeamCoverLeft.stl

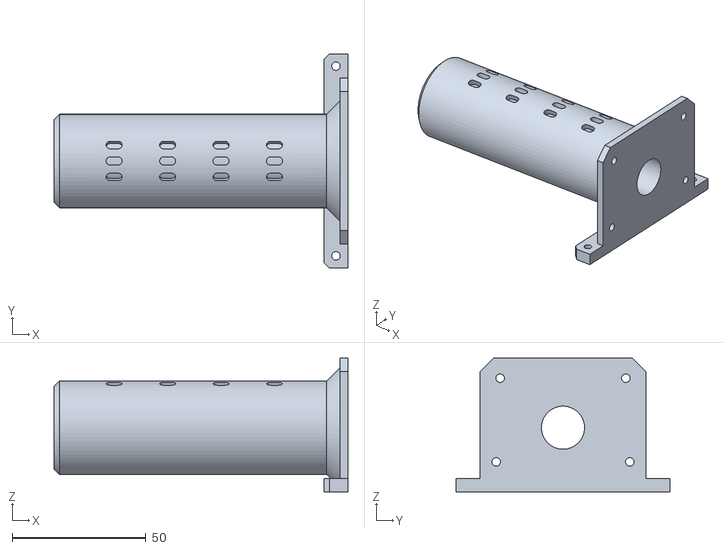
[picture p13: CAD file, 2024-09-02]
3D_PrintedParts_v1_00_1829_07062024/LensHolder_D42F65/BeamCoverLeft.stl
110.0 x 80.0 x 50.0
