ppak10/Inova/3D_PrintedParts_v1_00_1829_07062024/Nema17Holders/Nema17Holder.stl

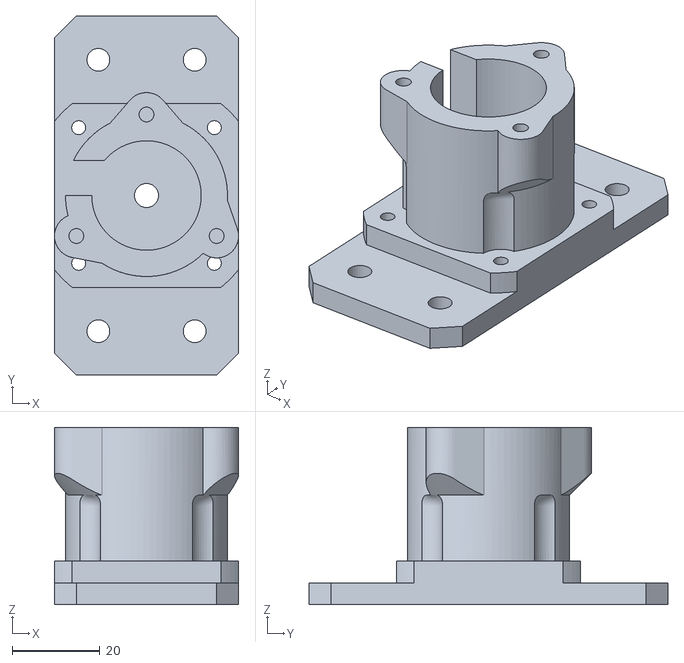
[picture p14: CAD file, 2024-09-02]
3D_PrintedParts_v1_00_1829_07062024/Nema17Holders/Nema17Holder.stl
42.0 x 82.0 x 40.5
