ppak10/Inova/3D_PrintedParts_v1_00_1829_07062024/OverPowderBin/PlasticCorner.stl

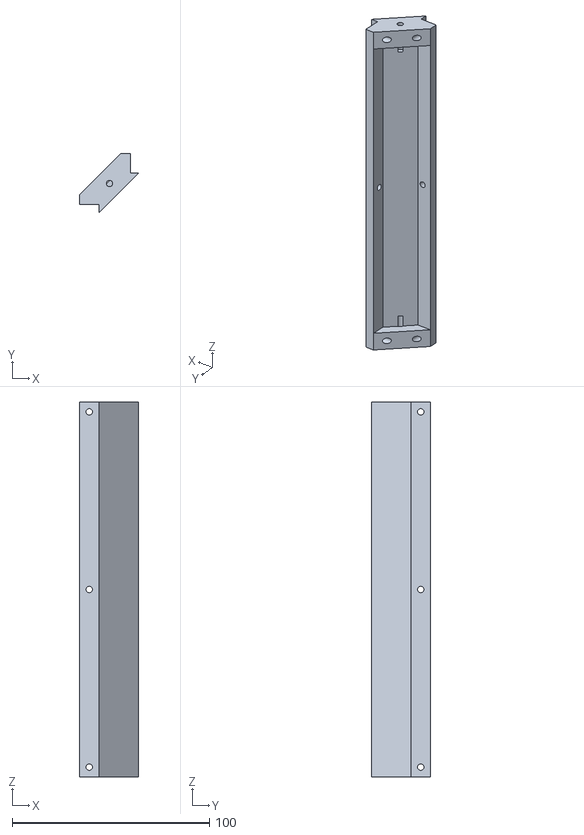
[picture p15: CAD file, 2024-09-02]
3D_PrintedParts_v1_00_1829_07062024/OverPowderBin/PlasticCorner.stl
30.0 x 30.0 x 190.0
