ppak10/Inova/3D_PrintedParts_v1_00_1829_07062024/RPiFanHolders/RockPiFanHolder.stl

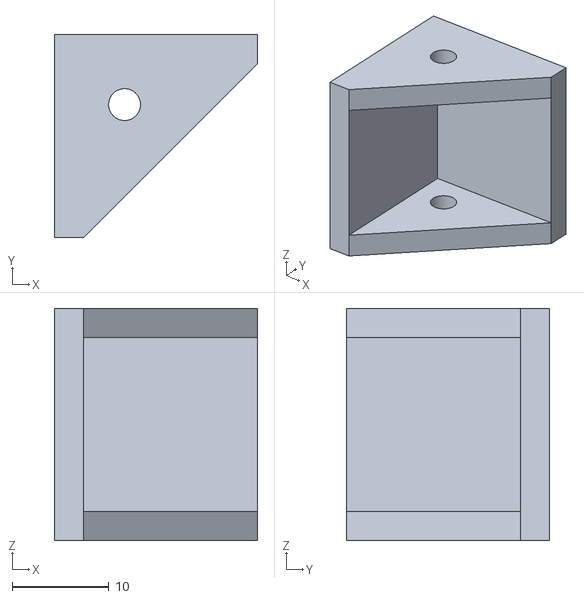
[picture p16: CAD file, 2024-09-02]
3D_PrintedParts_v1_00_1829_07062024/RPiFanHolders/RockPiFanHolder.stl
21.0 x 21.0 x 24.0
