ppak10/Inova/3D_PrintedParts_v1_00_1829_07062024/SafetySwitchHolders/SafetySwitchHolderBottom.stl

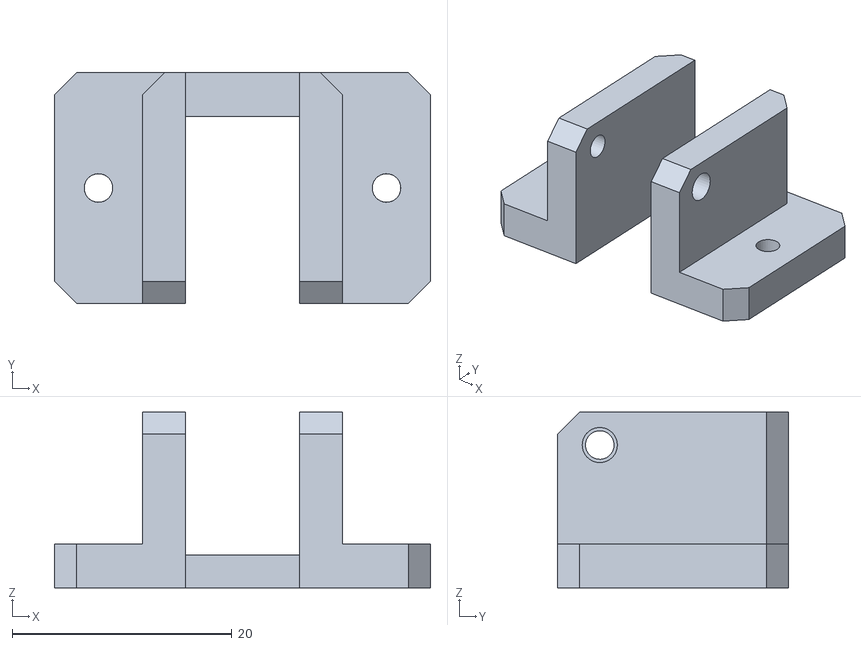
[picture p17: CAD file, 2024-09-02]
3D_PrintedParts_v1_00_1829_07062024/SafetySwitchHolders/SafetySwitchHolderBottom.stl
34.2 x 21.0 x 16.0
