ppak10/Inova/3D_PrintedParts_v1_00_1829_07062024/ThermoCameraHolder/ThermoCameraHolder.stl

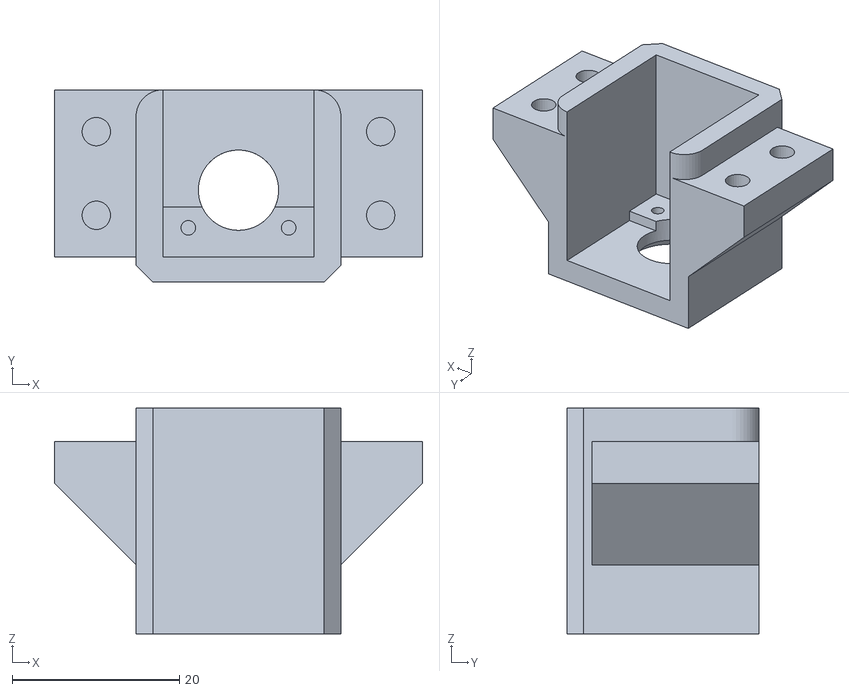
[picture p18: CAD file, 2024-09-02]
3D_PrintedParts_v1_00_1829_07062024/ThermoCameraHolder/ThermoCameraHolder.stl
44.0 x 23.0 x 27.0
