ppak10/Inova/3D_PrintedParts_v1_00_1829_07062024/VideoCameraHolder/VideoCameraHolder.stl

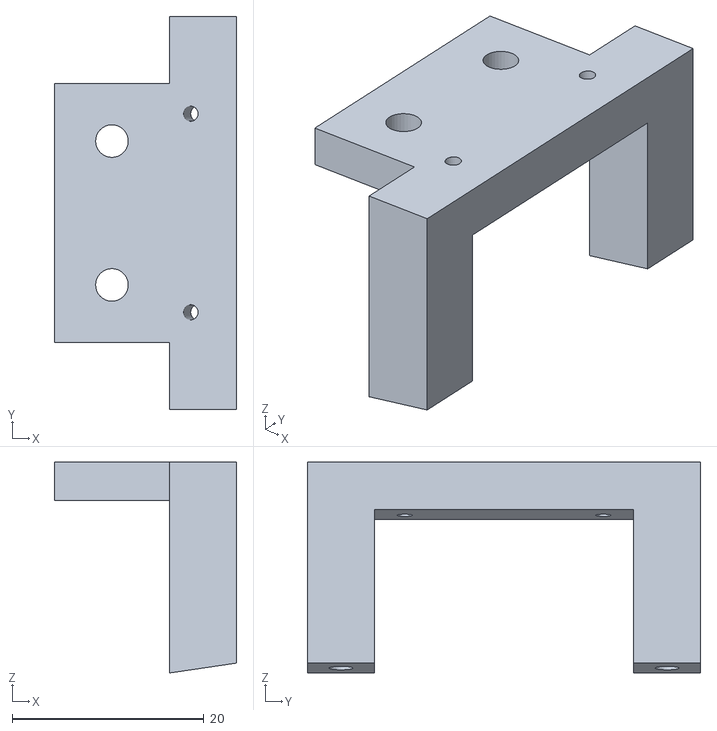
[picture p19: CAD file, 2024-09-02]
3D_PrintedParts_v1_00_1829_07062024/VideoCameraHolder/VideoCameraHolder.stl
19.0 x 41.0 x 22.0
