ppak10/Inova/3D_PrintedParts_v1_00_1829_07062024/WobblerBalancer/WobblerNutHolder.stl

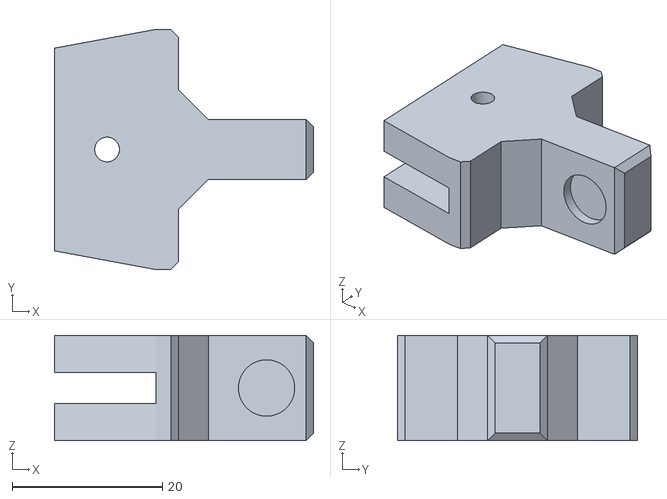
[picture p20: CAD file, 2024-09-02]
3D_PrintedParts_v1_00_1829_07062024/WobblerBalancer/WobblerNutHolder.stl
34.5 x 32.0 x 14.0
