ppak10/Inova/3D_Printed_Tools/CakeRemovalTool/CRT_Right.stl

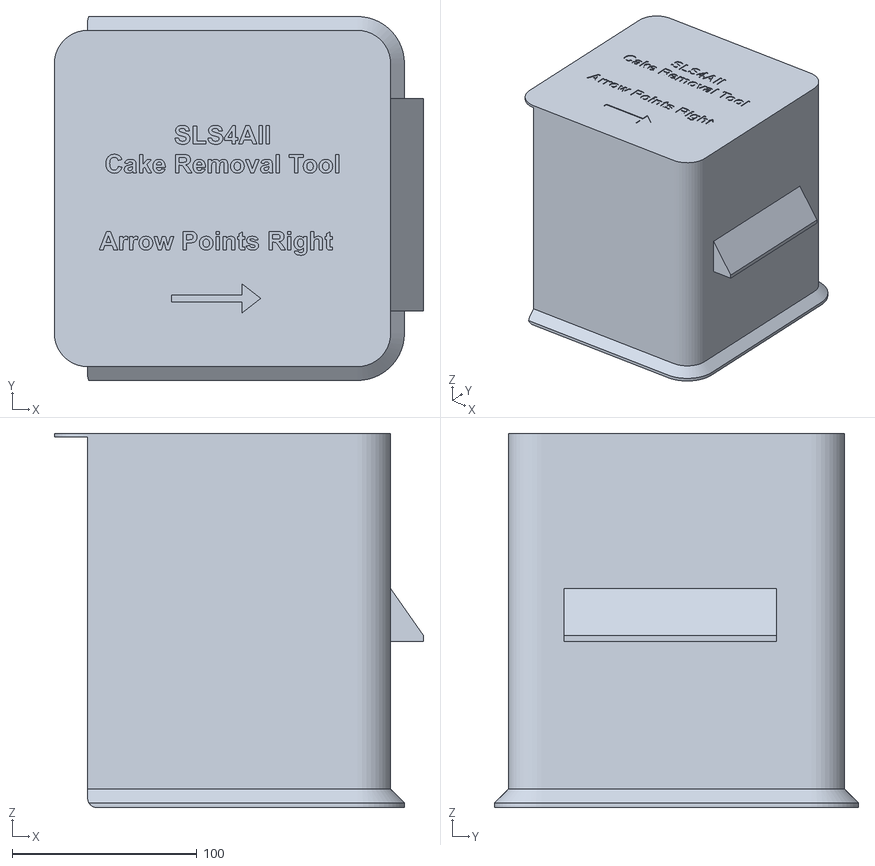
[picture p21: CAD file, 2025-12-07]
3D_Printed_Tools/CakeRemovalTool/CRT_Right.stl
199.9 x 197.0 x 202.5
