ppak10/Inova/3D_PrintedParts_v1_00_1829_07062024/BeltTensionerSet/PulleyHolder.stl

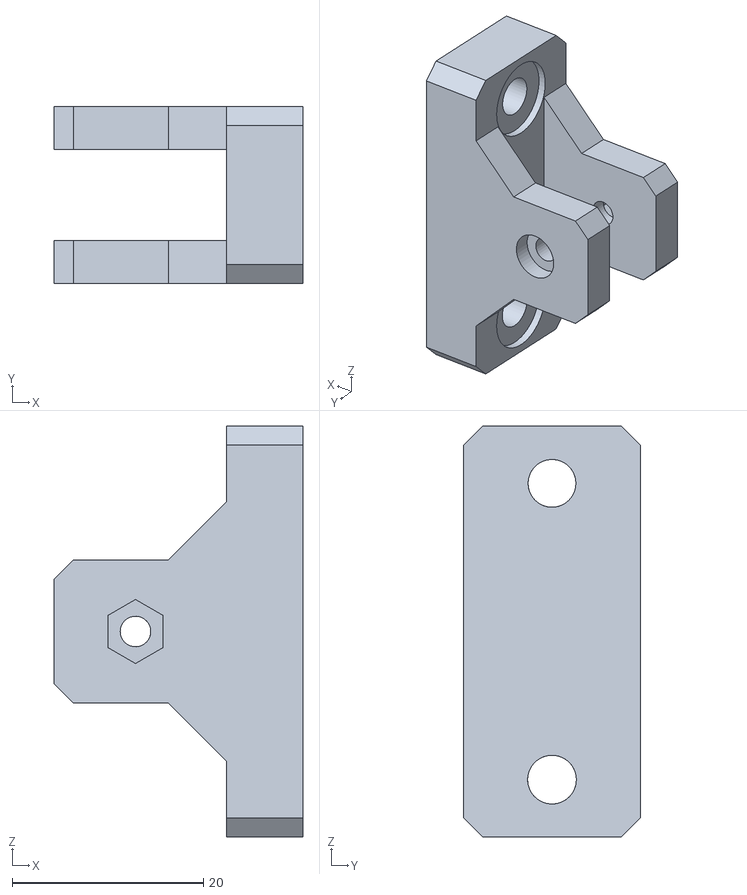
[picture p22: CAD file, 2024-09-02]
3D_PrintedParts_v1_00_1829_07062024/BeltTensionerSet/PulleyHolder.stl
26.0 x 18.5 x 43.0
