ppak10/Inova/3D_PrintedParts_v1_00_1829_07062024/BladeHolderSet/BladeHolderBack.stl

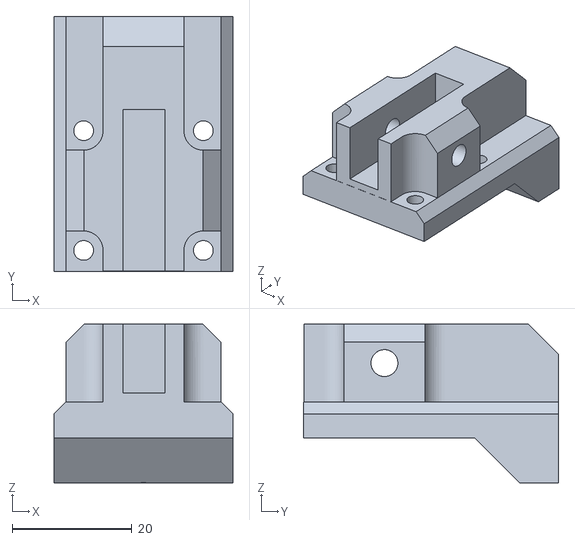
[picture p23: CAD file, 2024-09-02]
3D_PrintedParts_v1_00_1829_07062024/BladeHolderSet/BladeHolderBack.stl
29.9 x 42.6 x 26.5
