ppak10/Inova/3D_PrintedParts_v1_00_1829_07062024/CableClips/CableClipBig.stl

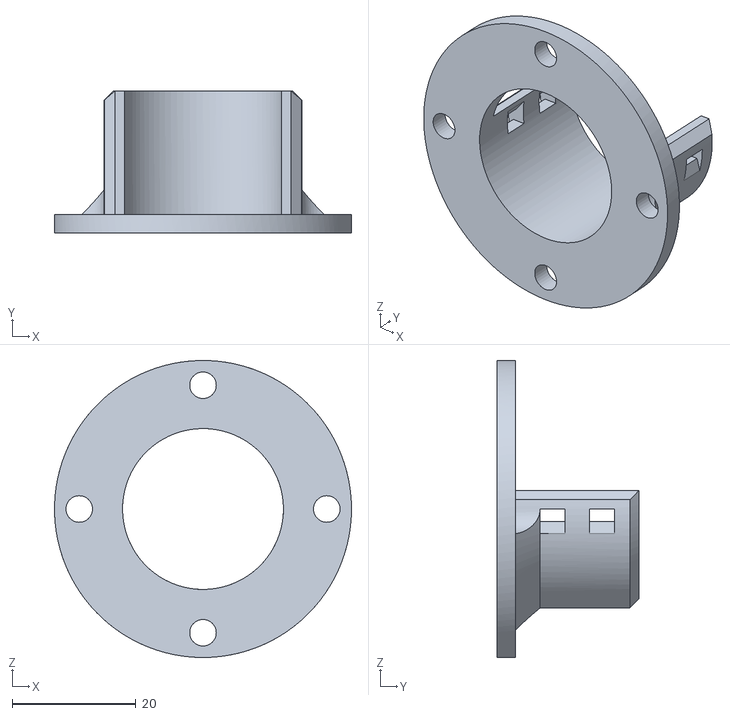
[picture p24: CAD file, 2024-09-02]
3D_PrintedParts_v1_00_1829_07062024/CableClips/CableClipBig.stl
48.0 x 23.0 x 48.0
