ppak10/Inova/3D_PrintedParts_v1_00_1829_07062024/DisplaySet/TopDisplayCover.stl

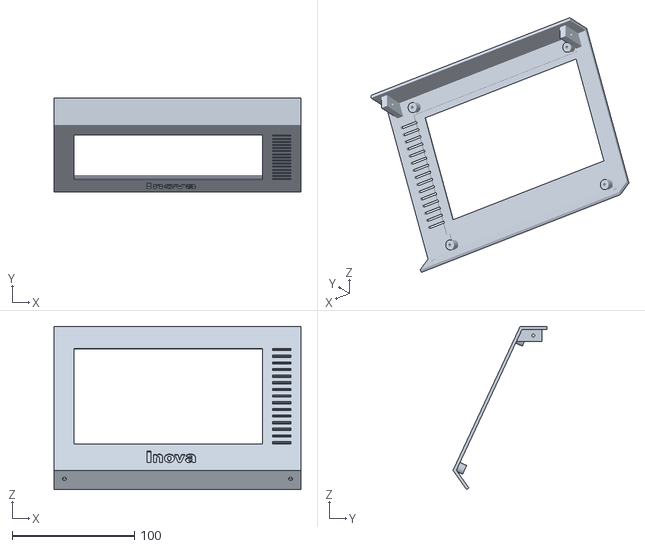
[picture p25: CAD file, 2024-09-02]
3D_PrintedParts_v1_00_1829_07062024/DisplaySet/TopDisplayCover.stl
202.0 x 76.9 x 133.6
