ppak10/Inova/3D_PrintedParts_v1_00_1829_07062024/ElectronicsDistanceSpacers/ElectronicsSpacer_5mm.stl

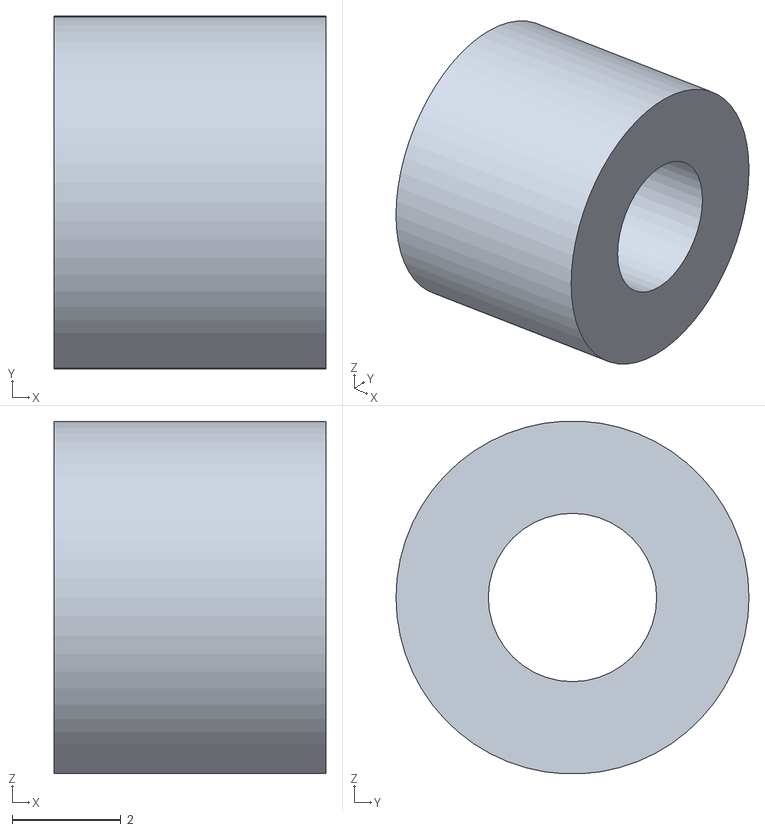
[picture p26: CAD file, 2024-09-02]
3D_PrintedParts_v1_00_1829_07062024/ElectronicsDistanceSpacers/ElectronicsSpacer_5mm.stl
5.00 x 6.50 x 6.49
