ppak10/Inova/3D_PrintedParts_v1_00_1829_07062024/Nema17Holders/Nema17HolderLid.stl

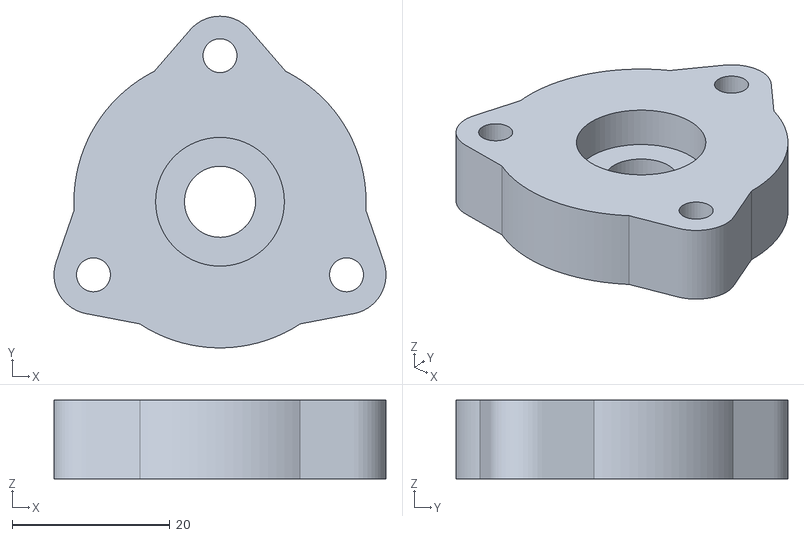
[picture p28: CAD file, 2024-09-02]
3D_PrintedParts_v1_00_1829_07062024/Nema17Holders/Nema17HolderLid.stl
42.0 x 42.0 x 10.0
