ppak10/Inova/3D_PrintedParts_v1_00_1829_07062024/OverPowderBin/TopBottomConnector.stl

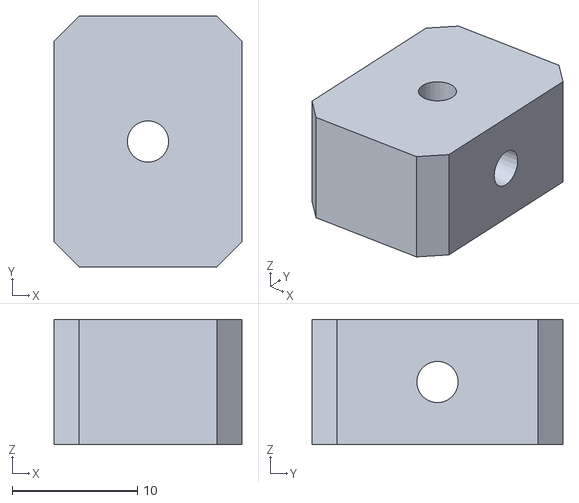
[picture p29: CAD file, 2024-09-02]
3D_PrintedParts_v1_00_1829_07062024/OverPowderBin/TopBottomConnector.stl
15.0 x 20.0 x 10.0
