ppak10/Inova/3D_PrintedParts_v1_00_1829_07062024/SafetySwitchHolders/SafetySwitchHolderTop.stl

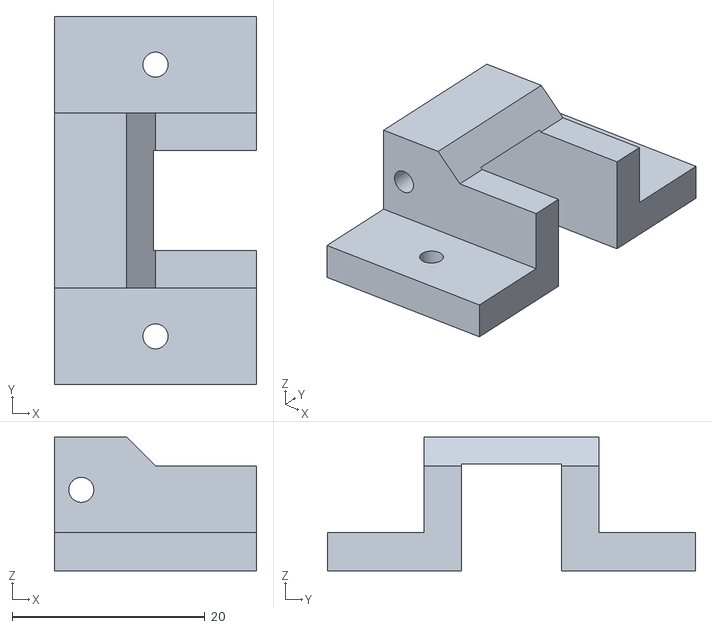
[picture p30: CAD file, 2024-09-02]
3D_PrintedParts_v1_00_1829_07062024/SafetySwitchHolders/SafetySwitchHolderTop.stl
21.0 x 38.2 x 13.9
