ppak10/Inova/3D_PrintedParts_v1_00_1829_07062024/WobblerBalancer/WobblerNutAretation.stl

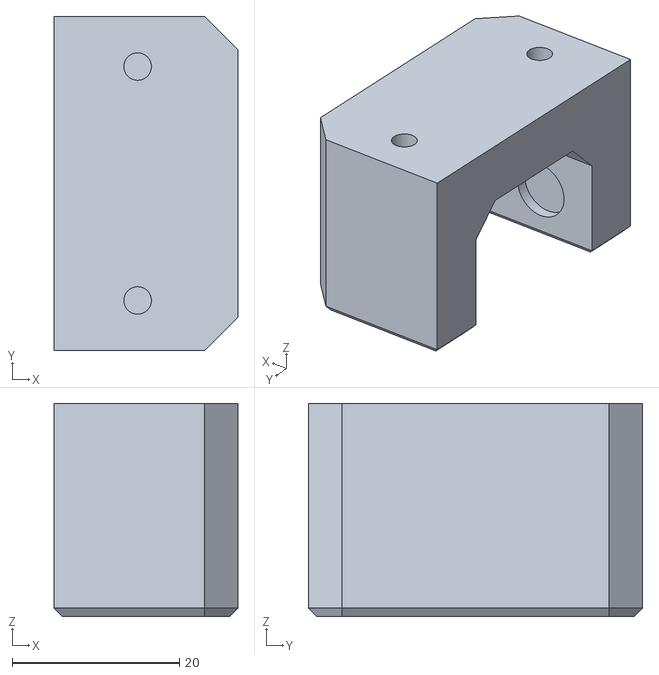
[picture p31: CAD file, 2024-09-02]
3D_PrintedParts_v1_00_1829_07062024/WobblerBalancer/WobblerNutAretation.stl
22.0 x 40.0 x 25.5
