ppak10/Inova/3D_PrintedParts_v1_00_1829_07062024/BladeHolderSet/BeltLock.stl

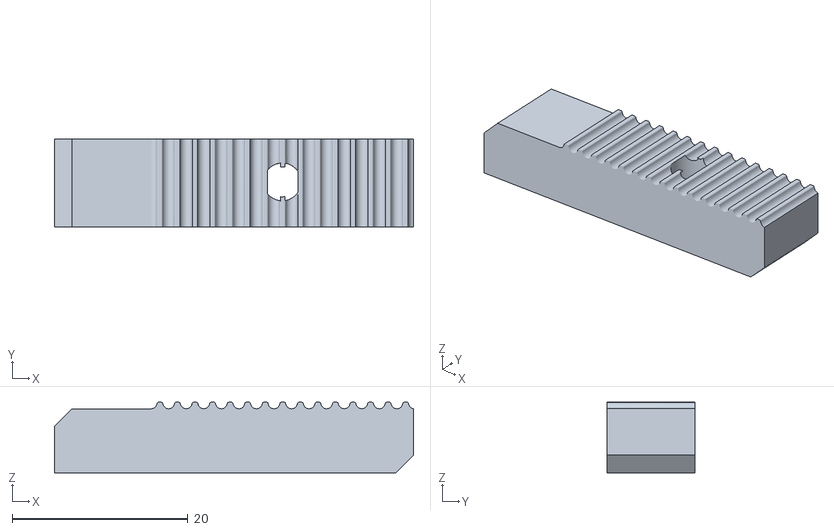
[picture p33: CAD file, 2024-09-02]
3D_PrintedParts_v1_00_1829_07062024/BladeHolderSet/BeltLock.stl
40.9 x 10.0 x 8.04
