ppak10/Inova/3D_PrintedParts_v1_00_1829_07062024/ElectricBoxMounts/SSRBoxMountCenter.stl

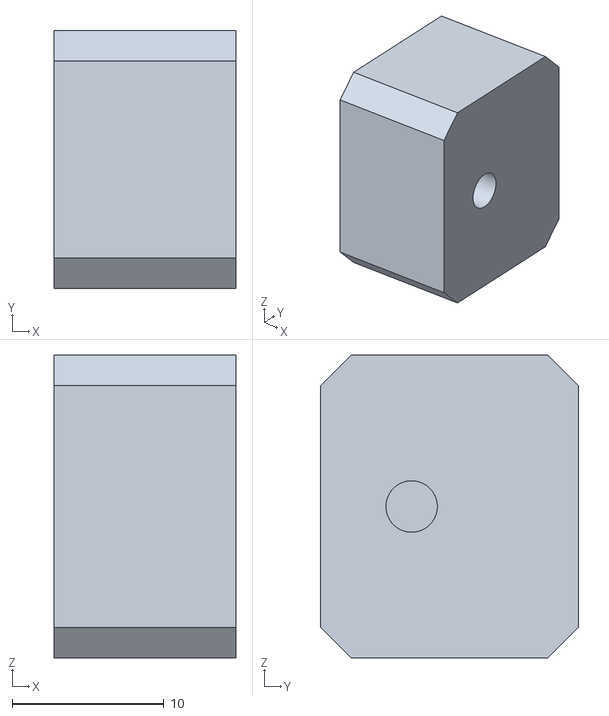
[picture p35: CAD file, 2024-09-02]
3D_PrintedParts_v1_00_1829_07062024/ElectricBoxMounts/SSRBoxMountCenter.stl
12.0 x 17.0 x 20.0
