ppak10/Inova/3D_PrintedParts_v1_00_1829_07062024/OverPowderBin/PrinterRailBack.stl

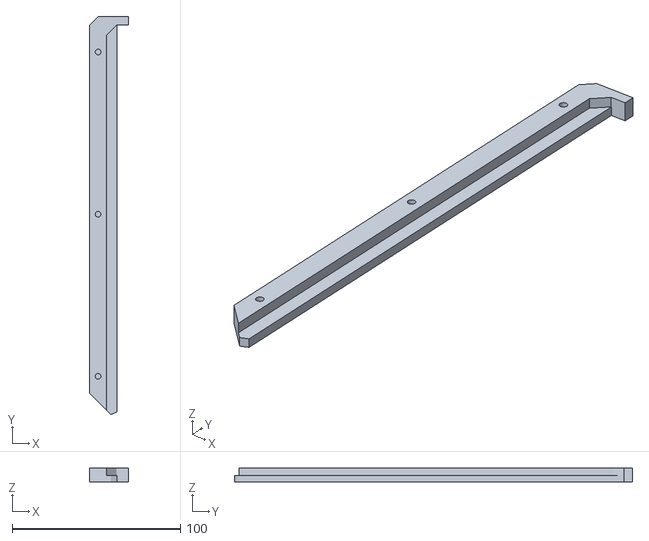
[picture p36: CAD file, 2024-09-02]
3D_PrintedParts_v1_00_1829_07062024/OverPowderBin/PrinterRailBack.stl
23.0 x 236.5 x 8.15
