ppak10/Inova/3D_PrintedParts_v1_00_1829_07062024/ElectricBoxMounts/SSRBoxMountTop.stl

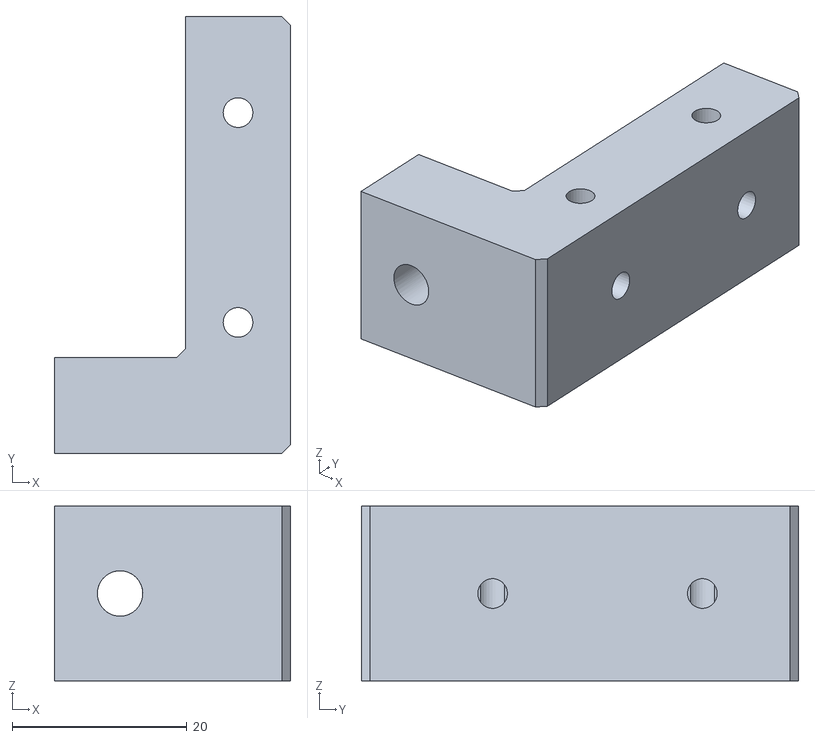
[picture p37: CAD file, 2024-09-02]
3D_PrintedParts_v1_00_1829_07062024/ElectricBoxMounts/SSRBoxMountTop.stl
27.0 x 50.0 x 20.0
