ppak10/Inova/3D_PrintedParts_v1_00_1829_07062024/OverPowderBin/PlateHolder.stl

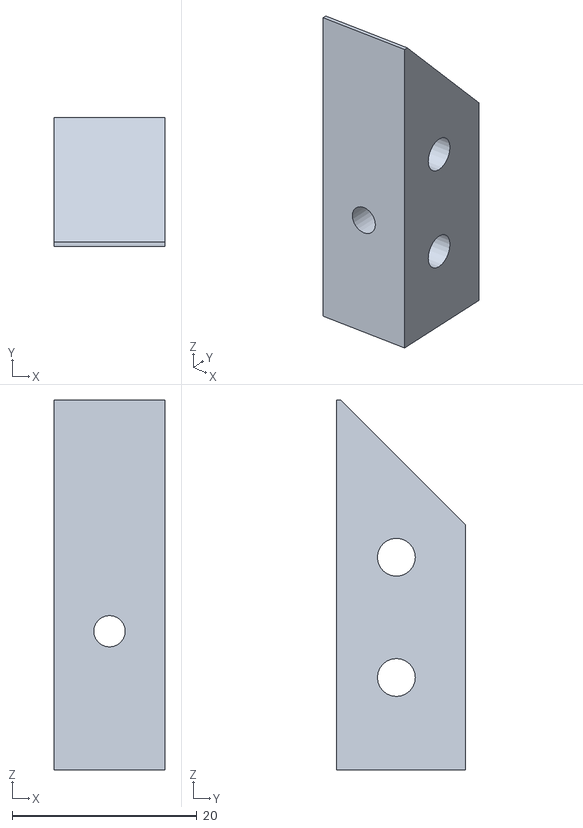
[picture p38: CAD file, 2024-09-02]
3D_PrintedParts_v1_00_1829_07062024/OverPowderBin/PlateHolder.stl
12.0 x 14.0 x 40.0
