ppak10/Inova/(list of files, cad)

Other CAD files:
3D_PrintedParts_v1_00_1829_07062024/ElectricBoxMounts/SSRBoxMountBottomR.stl
3D_PrintedParts_v1_00_1829_07062024/OverPowderBin/PrinterRailFront.stl
