ppak10/Inova/(commit log)

2024-09-02 Adds resource files and BOM.
    [ALUB-FRAME-SET-_-ALU-Sheet_-Bottom-Frame-Set_BOM.xlsx, ALUT-FRAME-SET-_-ALU-Sheets_-Top-Frame-Set_BOM.xlsx, AllOtherConstructionPartsMK1_05062024.xlsx, BeamCoverLeft.stl, BeltLock.stl, BladeHolderBack.stl, BladeHolderFront.stl, BottomPlateHolder.stl]
2025-12-07 Adds 3D printed tools.
    [CRT_Left.stl, CRT_Right.stl, GA CalibrationTool.stl, PowderCompactionTool.stl]
